visgence/dac_module/readme.md

#Power DAC Module
A DAC biphasic +- 12v DAC that can run off any 3.3v or 5v microcontroller By Visgence Inc.
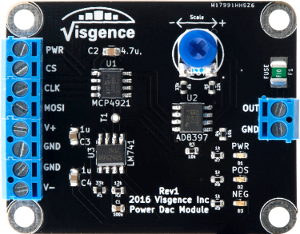
[picture p1: images/dac_module_small.jpg]
DAC Module


## Specs
* DAC IC: MCP4921
* Input V+
 * MAX: 12V
 * Min 3.3V
* Input V+
 * MAX: -12V
 * Min -3.3V
 
## Microcontroller Examples
* [MSP430G2] (Examples/MSP430G2231/sineWave)
* [mbed LPC1768] (Examples/mbed_LPC1768/sineWave)
* [Teensy3] (Examples/Teensy3/sineWave)
