visgence/dac_module/Examples/Teensy3/sineWave/readme.md

#Teensy 3.X Example
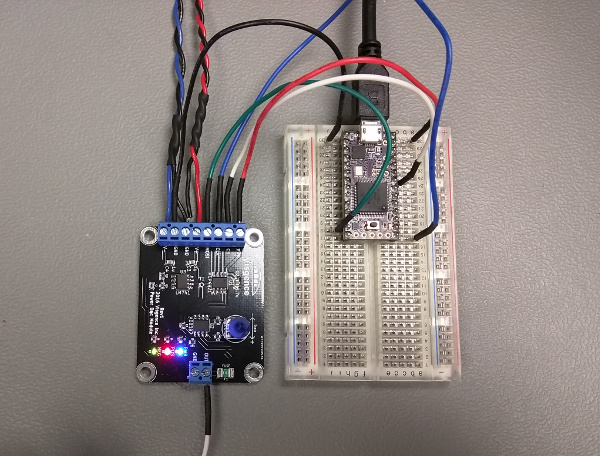
[picture p2: Examples/Teensy3/sineWave/images/teensy3.jpg]

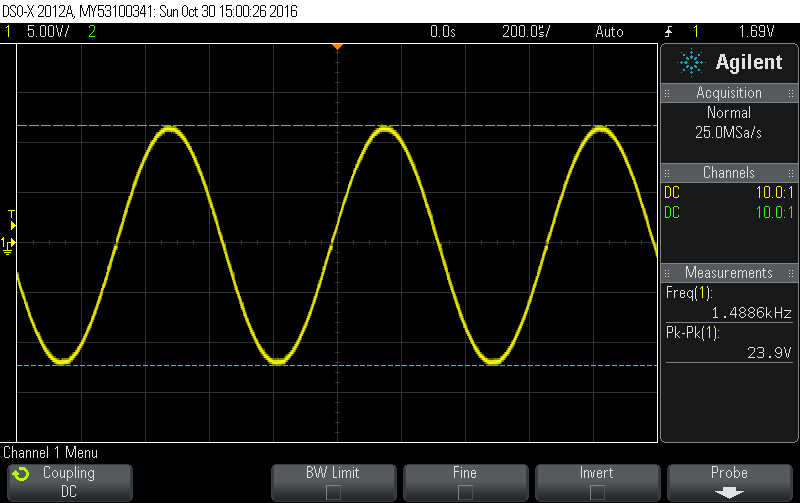
[picture p3: Examples/Teensy3/sineWave/images/teensy3_output.png]
