visgence/dac_module/Examples/mbed_LPC1768/sineWave/readme.md

#mbed LPC1768 Example
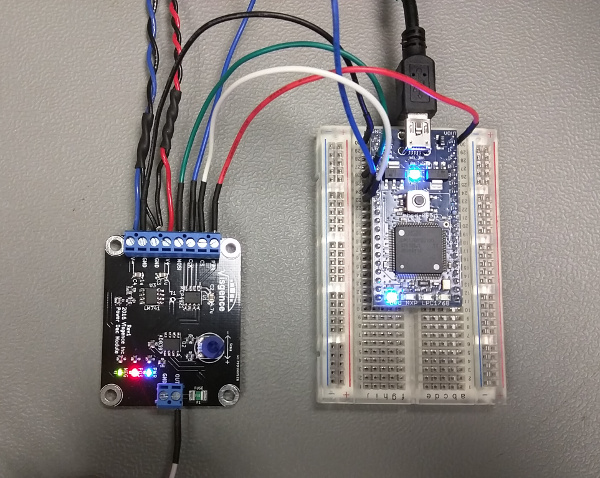
[picture p4: Examples/mbed_LPC1768/sineWave/images/mbed_LPC1768.jpg]

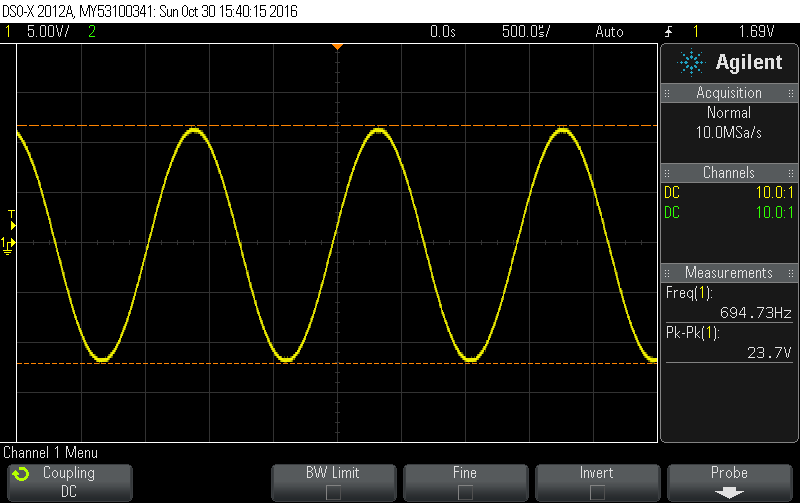
[picture p5: Examples/mbed_LPC1768/sineWave/images/mbed_LPC1768_output.png]
