visgence/dac_module/Examples/MSP430G2231/sineWave/readme.md

#MSP430G2231 Launchpad Example
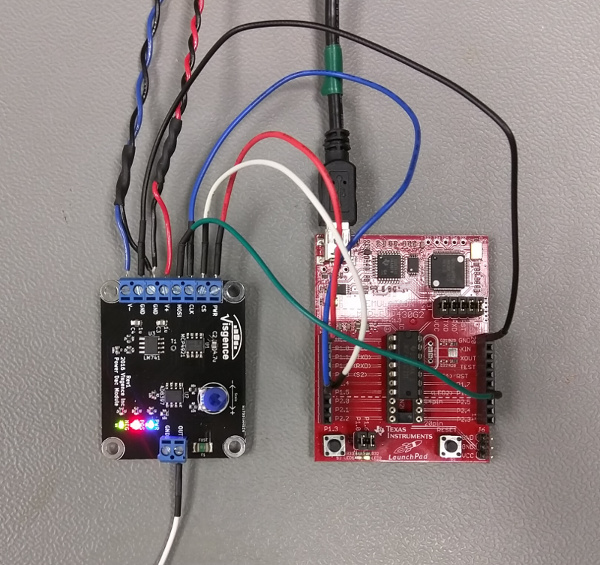
[picture p6: Examples/MSP430G2231/sineWave/images/msp430_launchpad.jpg]

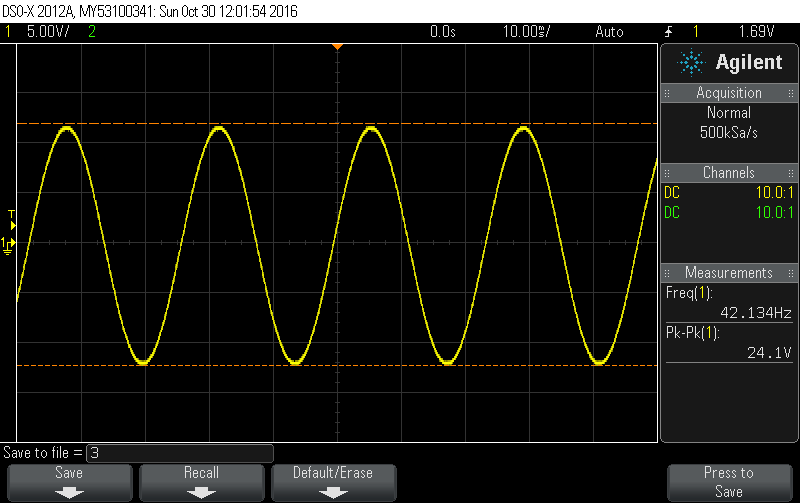
[picture p7: Examples/MSP430G2231/sineWave/images/msp430_output.png]
