visgence/dac_module/images/dac_module.jpg

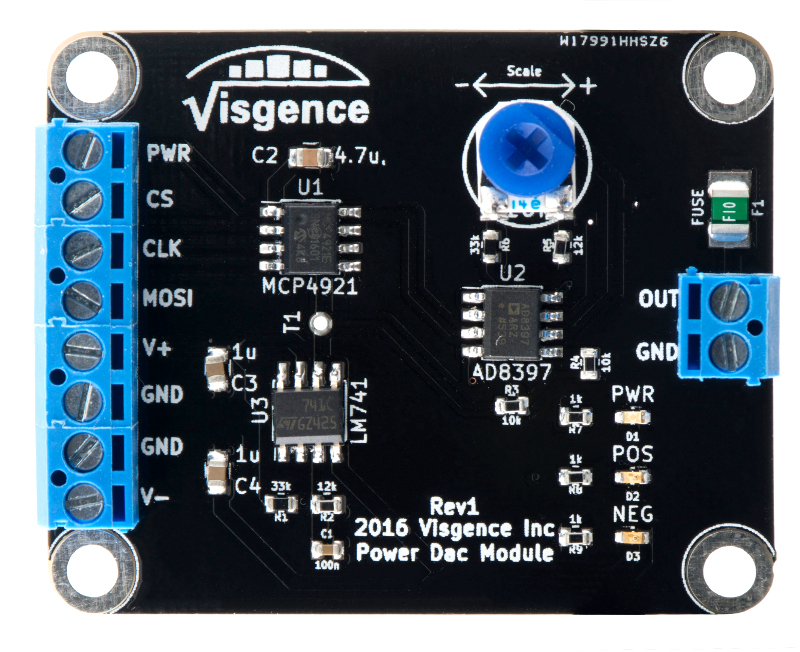
images/dac_module.jpg
