visgence/dac_module/dac_module.pdf

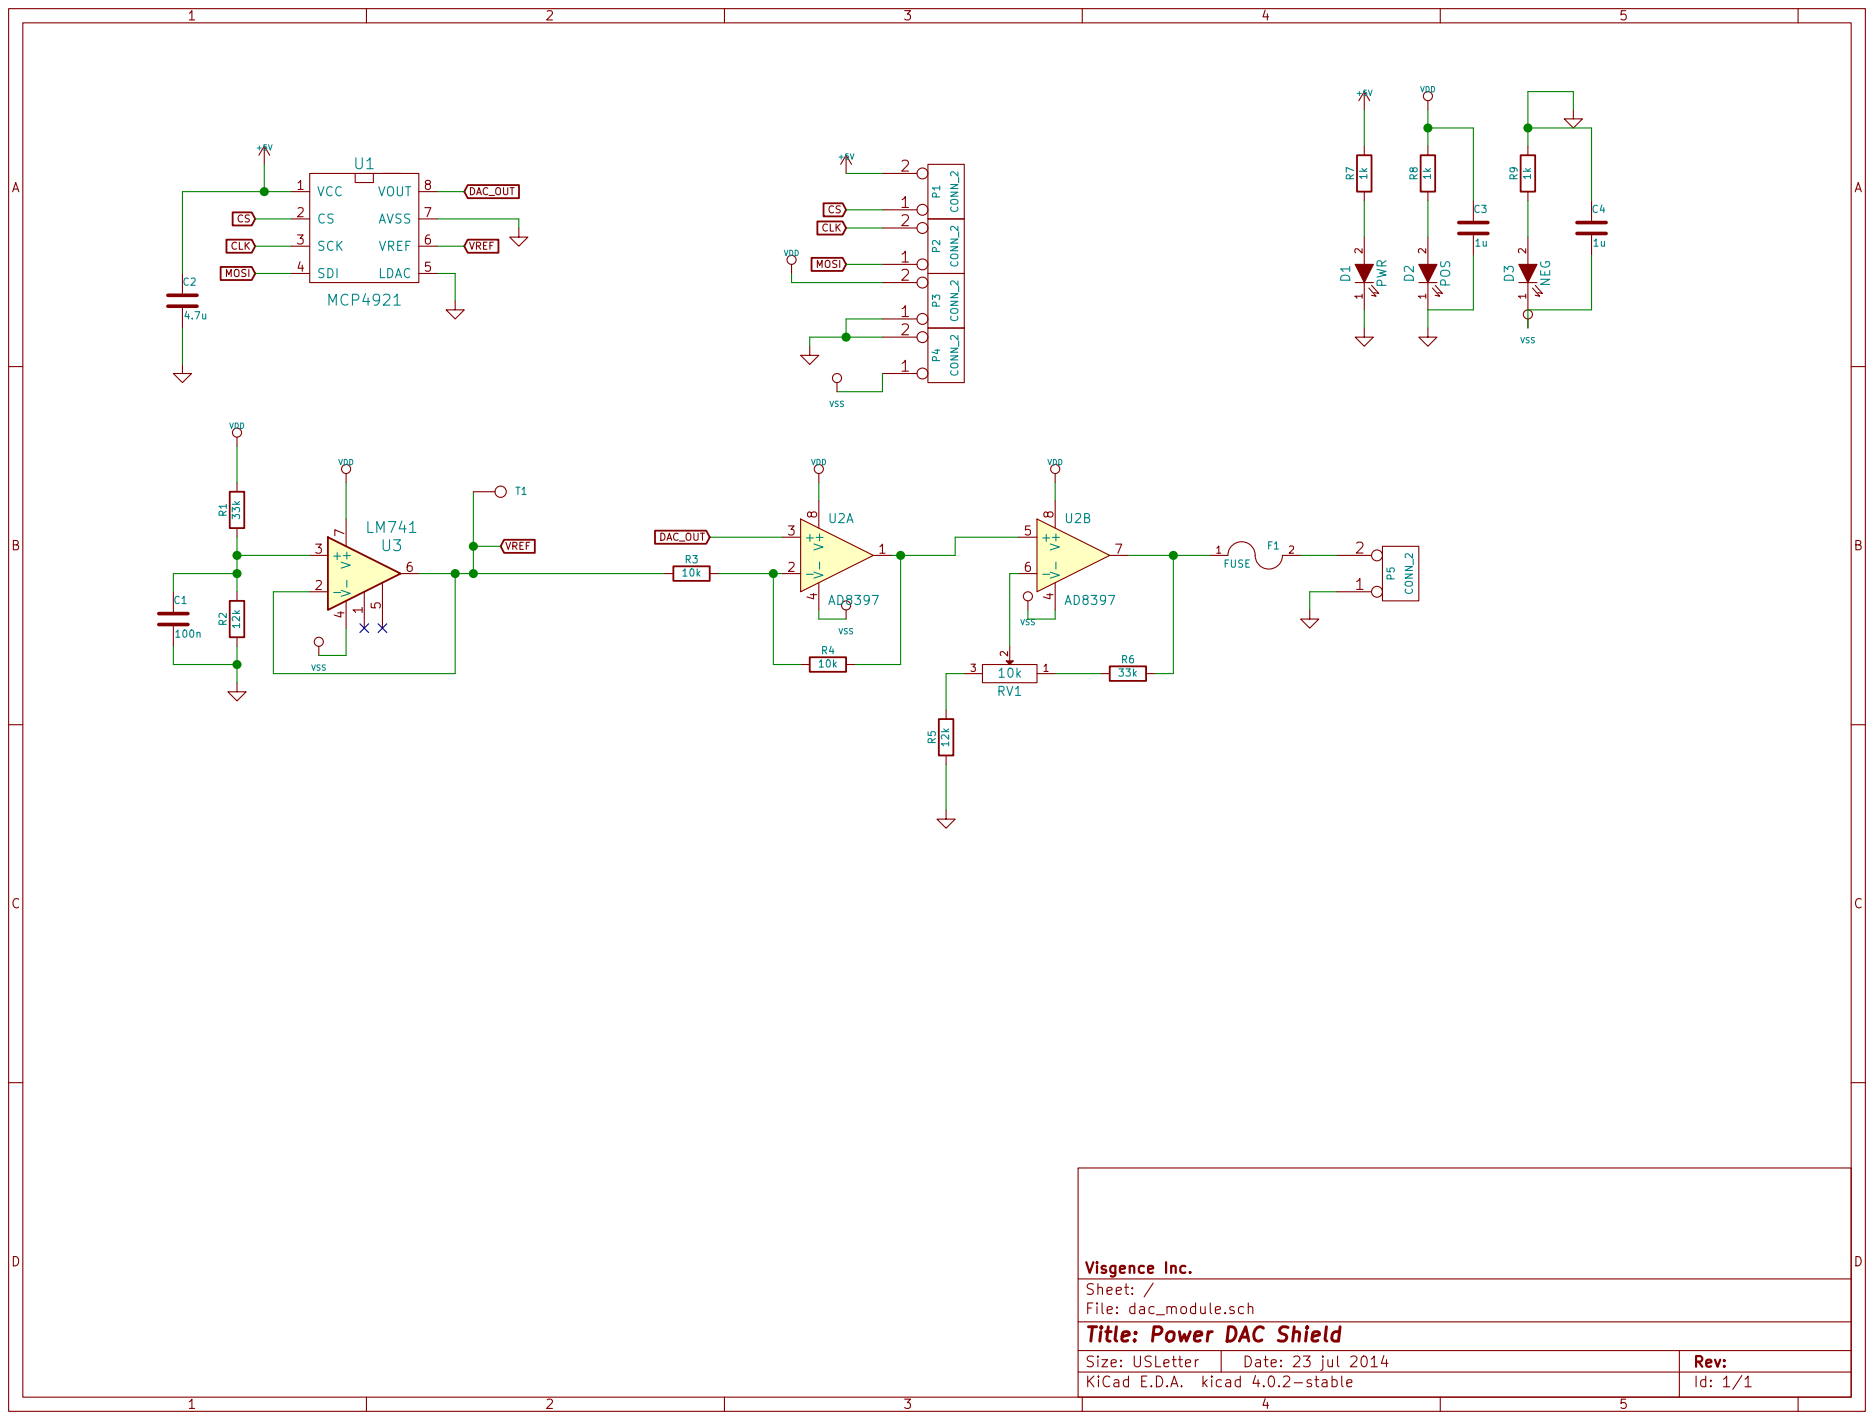
[picture p9: page 1]

File: dac_module.sch Sheet: / Visgence Inc.

Id: 1/1 Title: Power DAC Shield
