visgence/dac_module/(commit log)

2016-08-20 Fixed some things in the schematic, worked out layout
    [dac_module.kicad_pcb, dac_module.sch]
2016-08-20 Renamed output opamp
    [dac_module.kicad_pcb, dac_module.sch]
2016-08-22 Moved some parts arround, did first pass of routing
    [dac_module.kicad_pcb, dac_module.sch]
2016-08-22 Moved board, did copper fill
    [dac_module.kicad_pcb]
2016-08-22 changed 47u cap to 4.7u cap
    [dac_module.kicad_pcb, dac_module.sch]
2016-08-22 Rotated Pot, addded better logos
    [dac_module.kicad_pcb, dac_module.sch]
2016-08-22 Did routing
    [dac_module.kicad_pcb]
2016-10-29 Added Teensy3 Example
2016-10-29 Added images for Teensy3
2016-10-31 Added Schematic PDF
2017-04-04 Changed date to 2017
    [dac_module.kicad_pcb]
2019-12-03 Rotated screw terms, fixed resistors, upgraded to latest kicad
2019-12-03 Changed setting back, generated gerber files
    [dac_module.kicad_pcb, dac_module.sch]
